StefanHoria/KenoTemp-IoT-Weather-Station/docs/images/cod-main-2.png

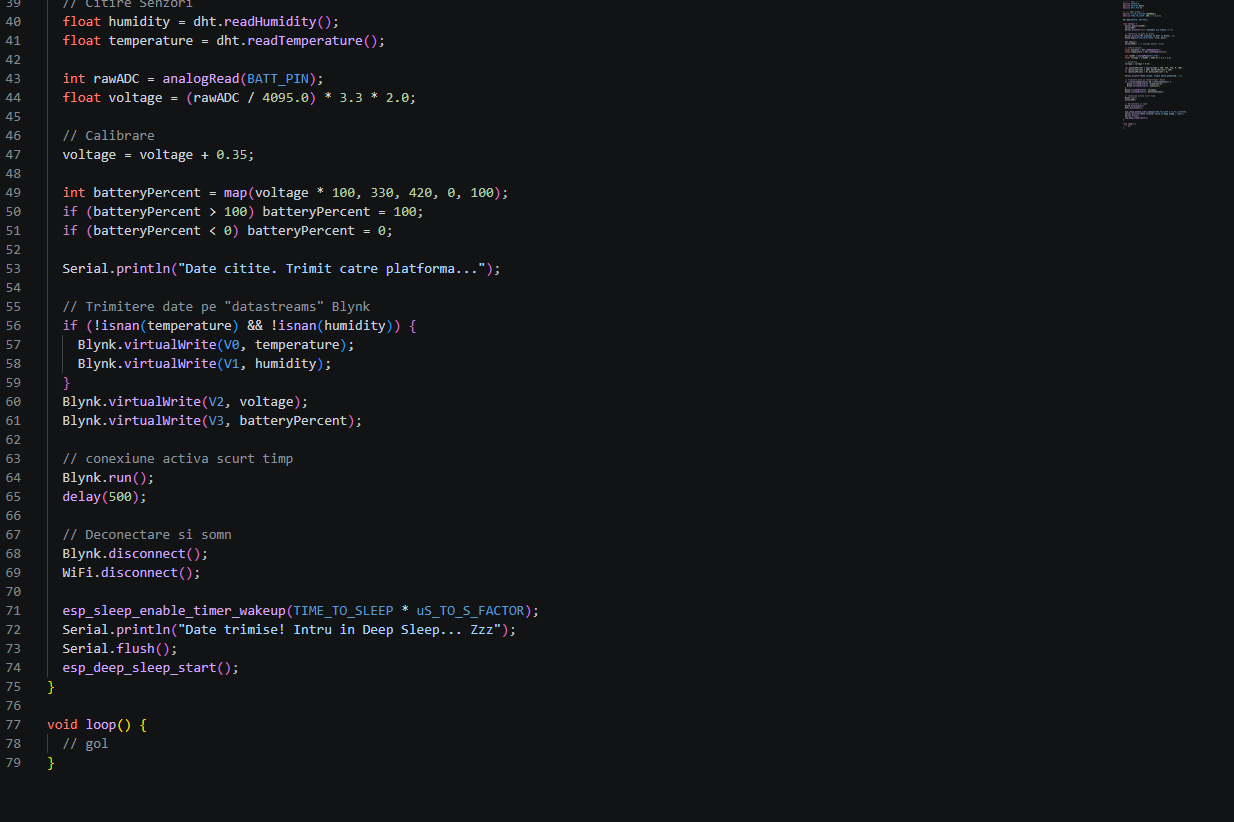
docs/images/cod-main-2.png
