StefanHoria/KenoTemp-IoT-Weather-Station/hardware/CarcasaTermo.stl

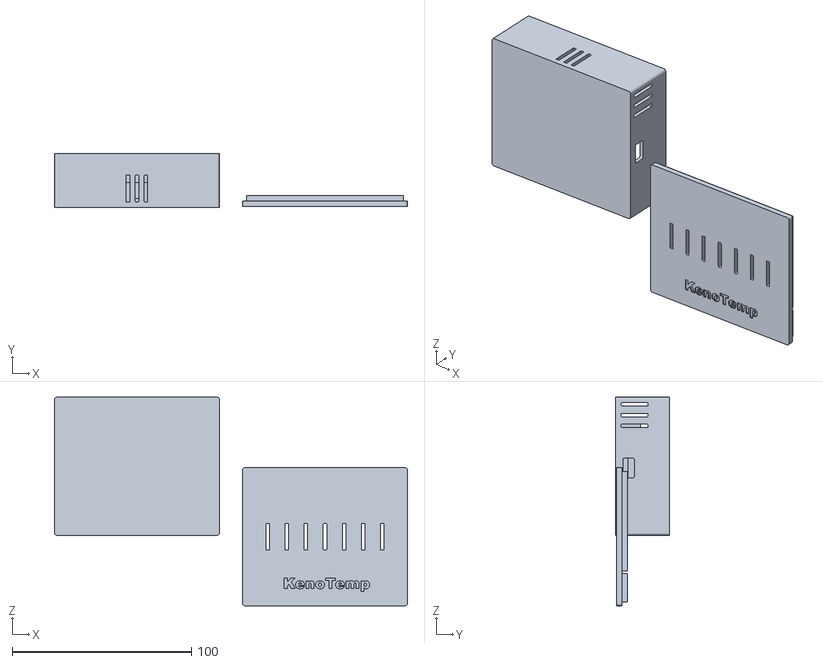
[picture p21: CAD file, 2026-09-01]
hardware/CarcasaTermo.stl
196.8 x 30.0 x 116.3
