StefanHoria/KenoTemp-IoT-Weather-Station/(notices)

Notices in the files:
README.md:
License: MIT
